kallaspriit/brainbot/README.md

# BrainBot

LLM based self-evolving robot experiment
