kallaspriit/brainbot/solidworks/beam-ball-assembly.SLDASM

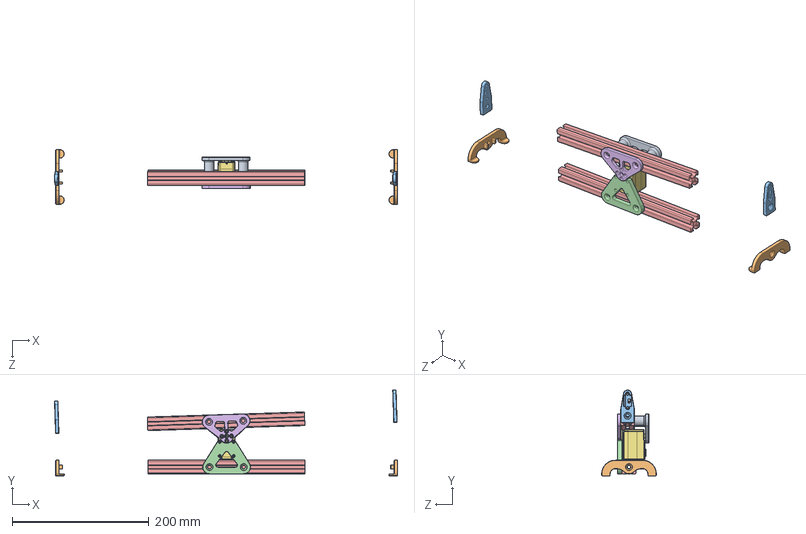
[picture p1: CAD file, 2026-08-09]
solidworks/beam-ball-assembly.SLDASM
501.8 x 125.7 x 80.0 mm
ST3215
servo-pivot
extrusion-20x20 x 2
motor-mount
beam-endstop x 2
rail-foot x 2
pivot-support
