kallaspriit/brainbot/sw/track-support-right.SLDASM

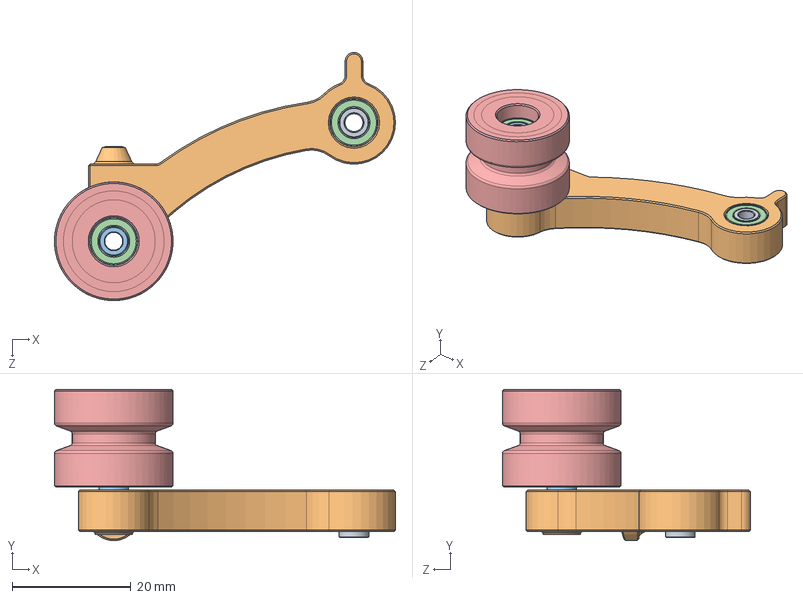
[picture p2: CAD file, 2026-11-13]
sw/track-support-right.SLDASM
57.5 x 25.5 x 41.8 mm
support-wheel
bearing-8x5x2.5 x 4
spacer-5mm-20mm
support-wheel-axle
spacer-5mm-8mm
