kallaspriit/brainbot/sw/idle-wheel-with-bearings.SLDASM

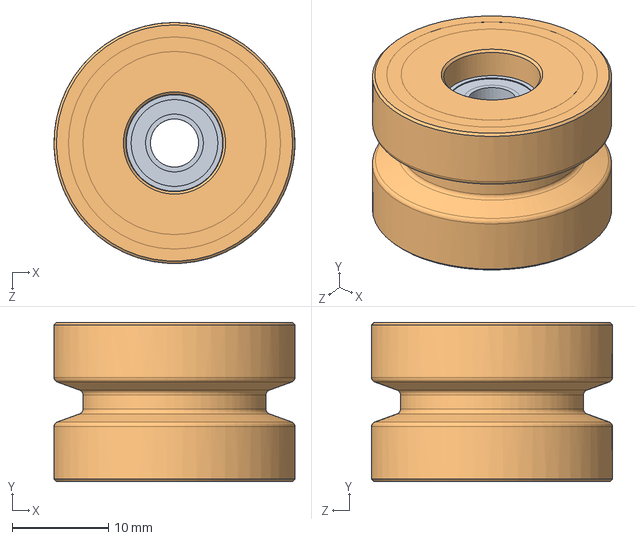
[picture p3: CAD file, 2026-11-11]
sw/idle-wheel-with-bearings.SLDASM
25.0 x 16.5 x 25.0 mm
idle-wheel
bearing-10x5x4 x 2
