kallaspriit/brainbot/solidworks/beam-endstop-sensored-collimator.SLDPRT

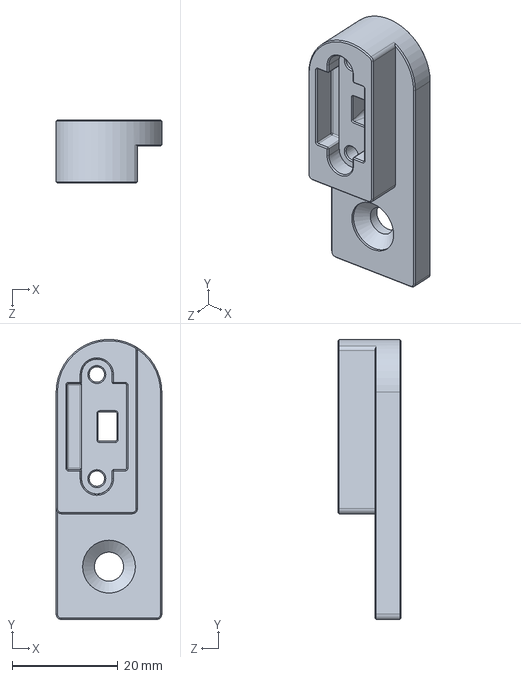
[picture p4: CAD file, 2026-11-05]
solidworks/beam-endstop-sensored-collimator.SLDPRT
20.0 x 53.0 x 12.0 mm
