kallaspriit/brainbot/step/body-side.STEP

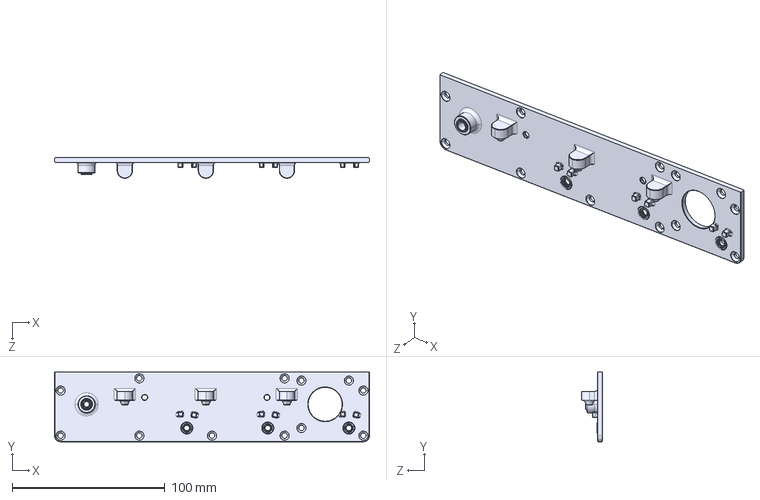
[picture p5: CAD file, 2026-11-14]
step/body-side.STEP
206.0 x 45.5 x 13.5 mm
