kallaspriit/brainbot/stl/damper-mount-fill.STL

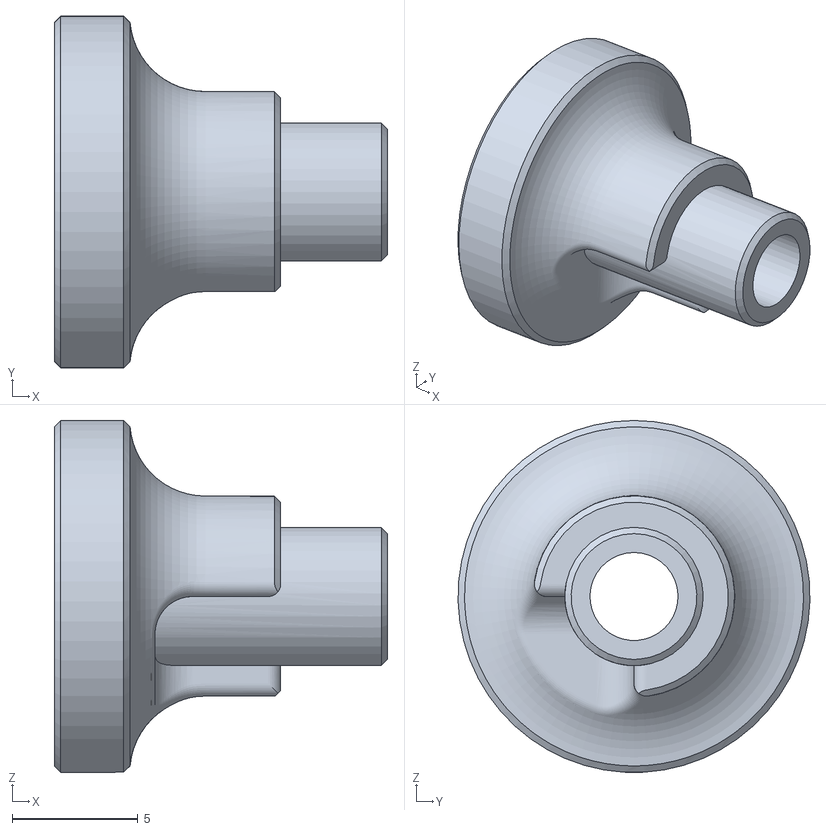
[picture p6: CAD file, 2026-08-09]
stl/damper-mount-fill.STL
13.2 x 14.0 x 14.0
