kallaspriit/brainbot/sw/support-wheel-axle.SLDPRT

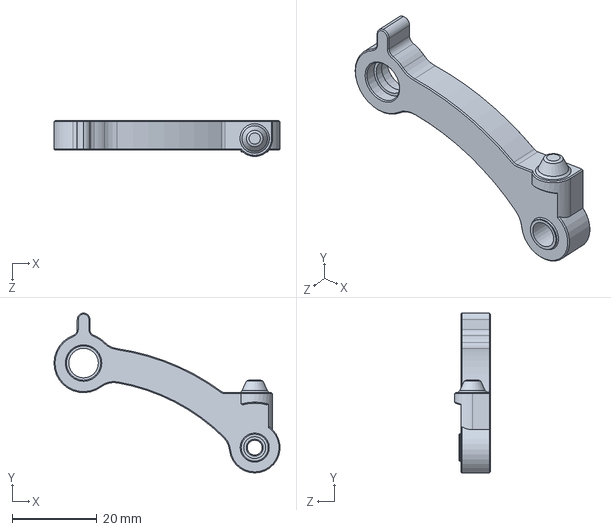
[picture p7: CAD file, 2026-11-14]
sw/support-wheel-axle.SLDPRT
53.5 x 37.8 x 8.50 mm
