kallaspriit/brainbot/step/support-wheel-axle-mirrored.STEP

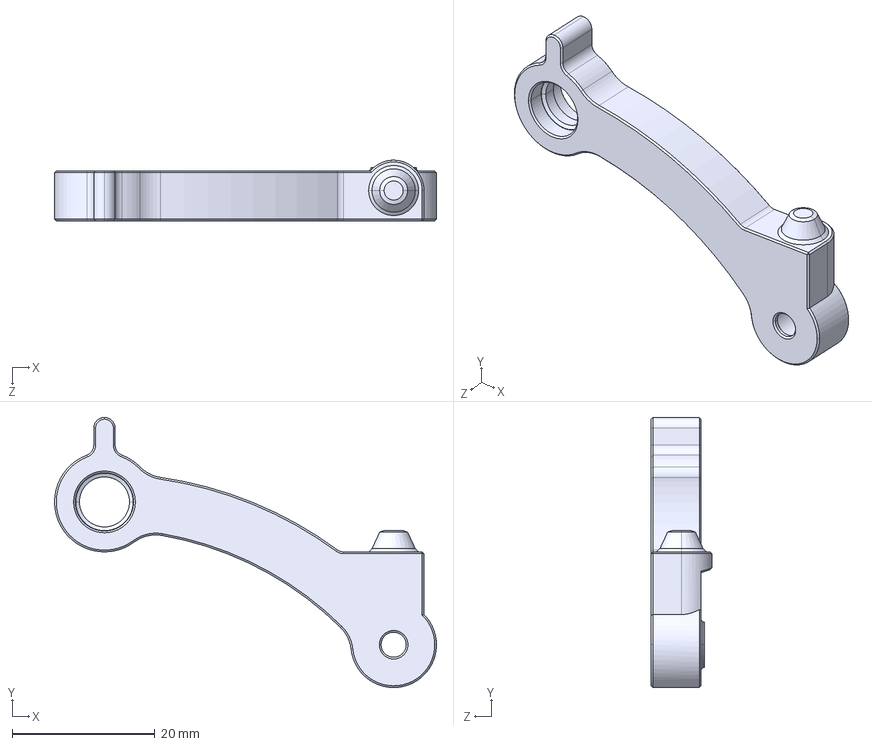
[picture p8: CAD file, 2026-11-14]
step/support-wheel-axle-mirrored.STEP
53.5 x 37.8 x 8.50 mm
