kallaspriit/brainbot/solidworks/beam-endstop.SLDPRT

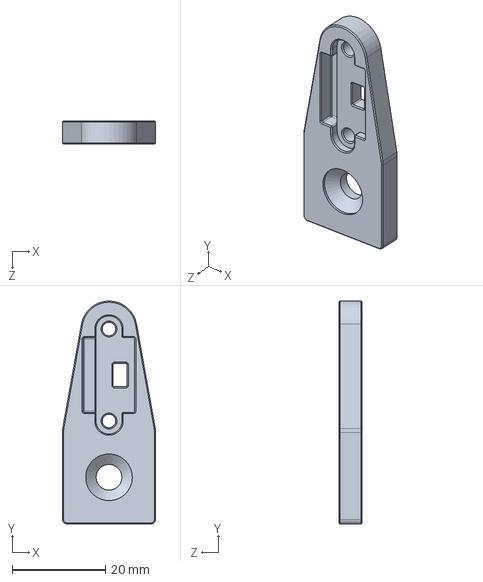
[picture p9: CAD file, 2026-08-09]
solidworks/beam-endstop.SLDPRT
20.0 x 47.7 x 5.00 mm
