kallaspriit/brainbot/step/side-cover-mirrored.STEP

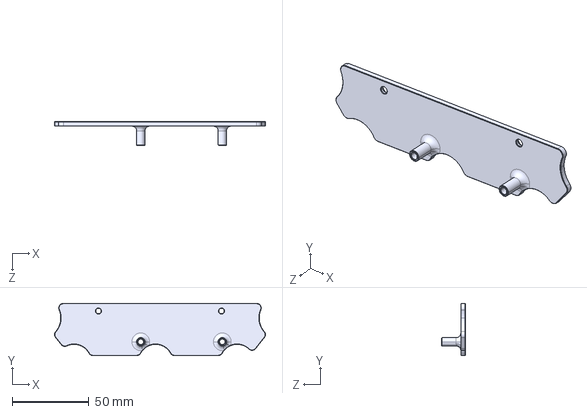
[picture p10: CAD file, 2026-11-14]
step/side-cover-mirrored.STEP
137.1 x 34.0 x 15.5 mm
