kallaspriit/brainbot/solidworks/motor-mount.SLDPRT

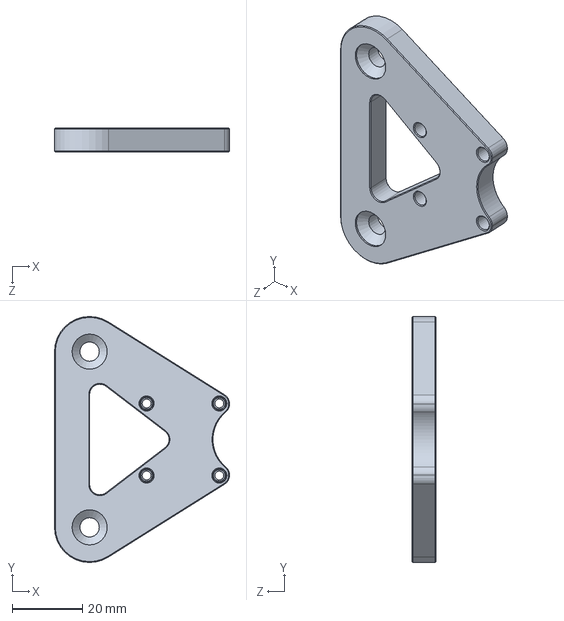
[picture p12: CAD file, 2026-08-09]
solidworks/motor-mount.SLDPRT
49.8 x 70.0 x 6.80 mm
