kallaspriit/brainbot/solidworks/beam-endstop-sensored.SLDPRT

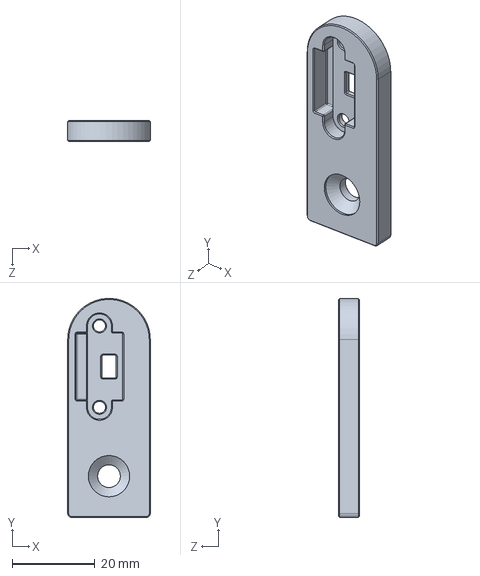
[picture p13: CAD file, 2026-08-09]
solidworks/beam-endstop-sensored.SLDPRT
20.0 x 53.0 x 5.00 mm
