kallaspriit/brainbot/solidworks/pivot-support.SLDPRT

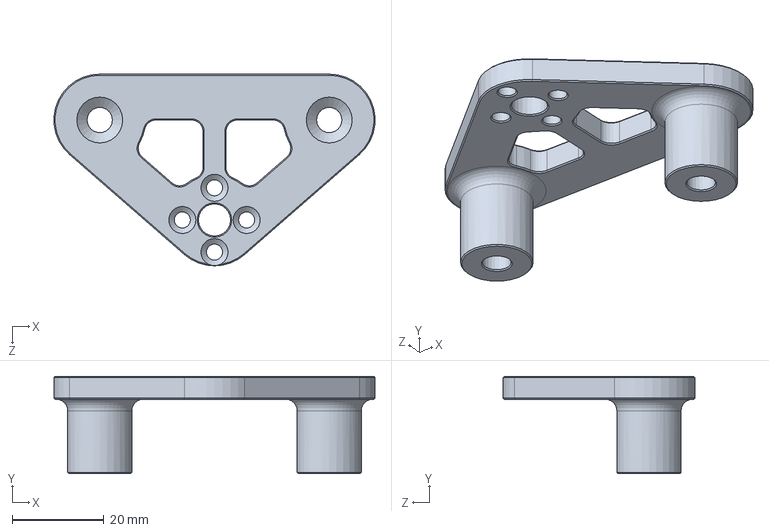
[picture p14: CAD file, 2026-08-09]
solidworks/pivot-support.SLDPRT
69.9 x 21.2 x 41.8 mm
