kallaspriit/brainbot/step/body-tub.STEP

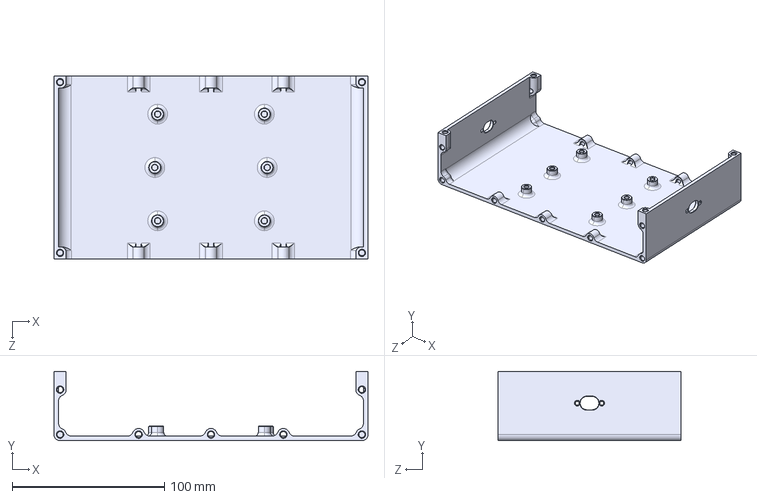
[picture p15: CAD file, 2026-11-14]
step/body-tub.STEP
206.0 x 45.5 x 120.0 mm
