kallaspriit/brainbot/sw/track-generated.SLDPRT

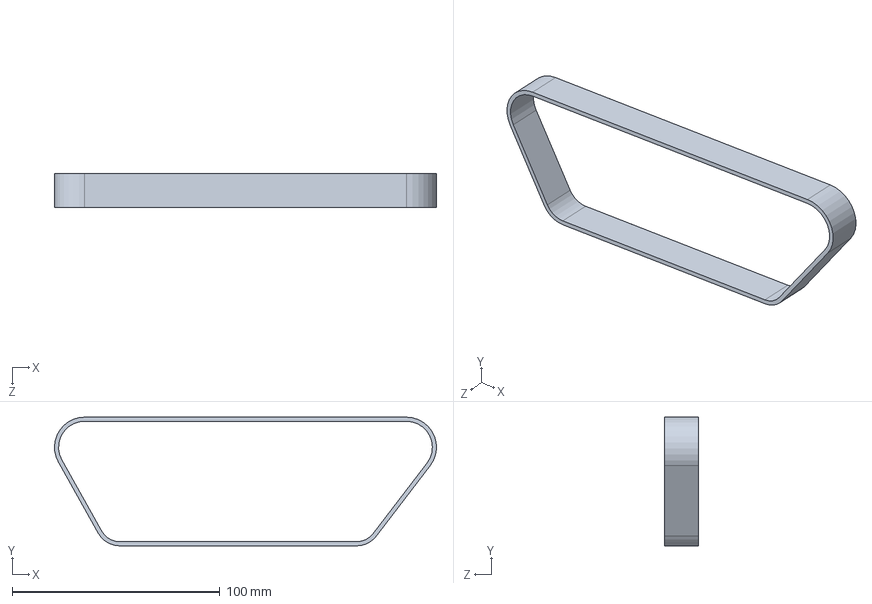
[picture p16: CAD file, 2026-11-13]
sw/track-generated.SLDPRT
184.0 x 62.0 x 16.5 mm
