kallaspriit/brainbot/solidworks/rail-foot.SLDPRT

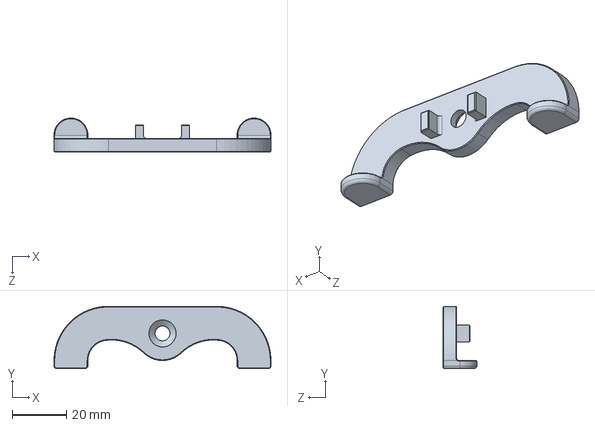
[picture p17: CAD file, 2026-08-06]
solidworks/rail-foot.SLDPRT
80.0 x 23.0 x 12.5 mm
