kallaspriit/brainbot/step/support-wheel.STEP

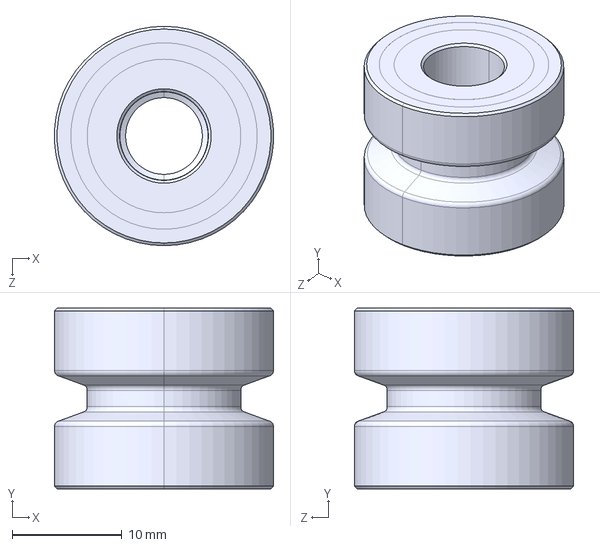
[picture p18: CAD file, 2026-11-11]
step/support-wheel.STEP
20.0 x 16.5 x 20.0 mm
