kallaspriit/brainbot/solidworks/ST3215.SLDPRT

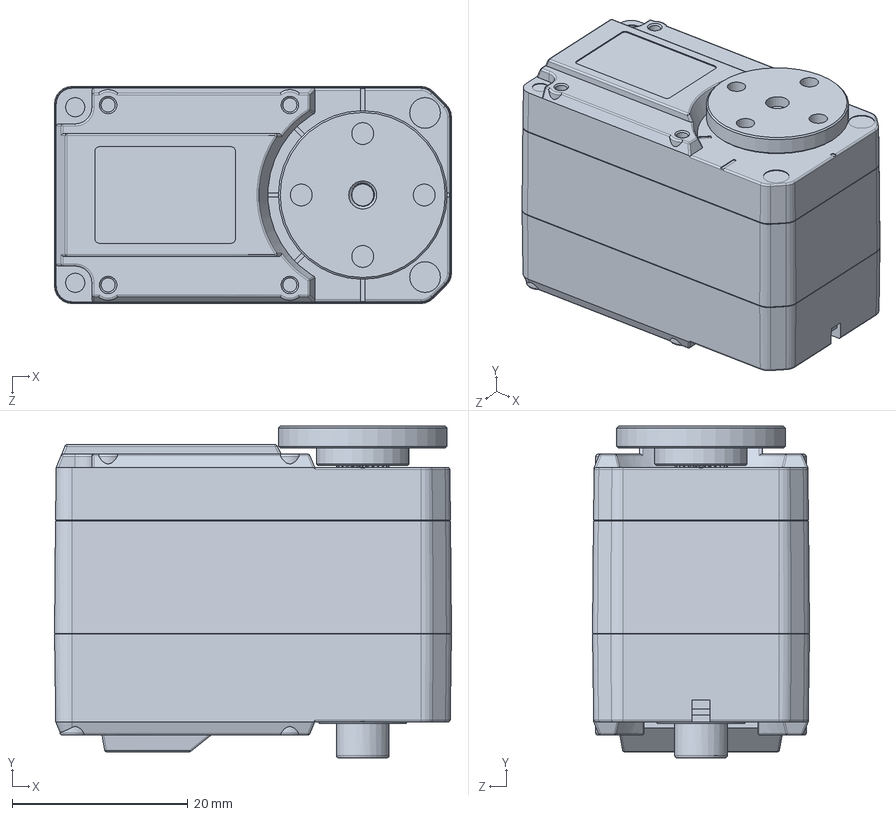
[picture p19: CAD file, 2026-08-06]
solidworks/ST3215.SLDPRT
45.2 x 37.8 x 24.7 mm
