kallaspriit/brainbot/step/idle-wheel.STEP

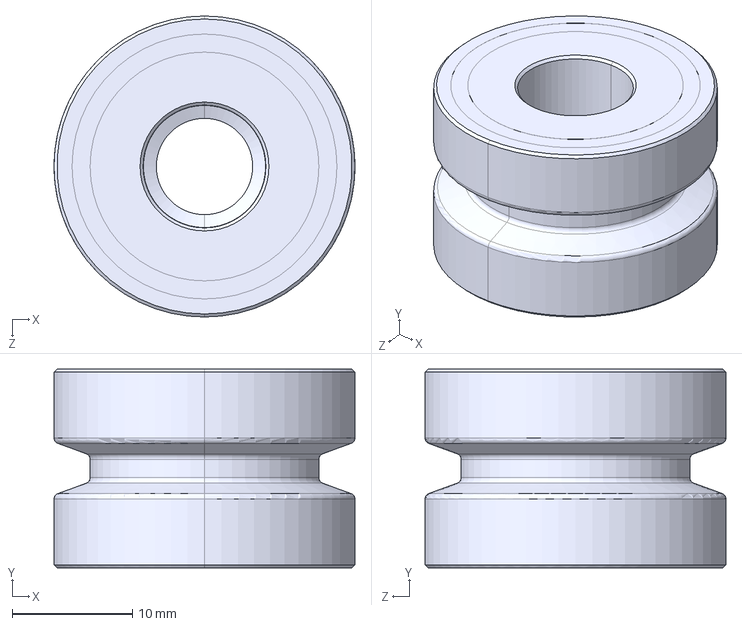
[picture p20: CAD file, 2026-11-11]
step/idle-wheel.STEP
25.0 x 16.5 x 25.0 mm
