kallaspriit/brainbot/solidworks/leg-arm-motor.SLDPRT

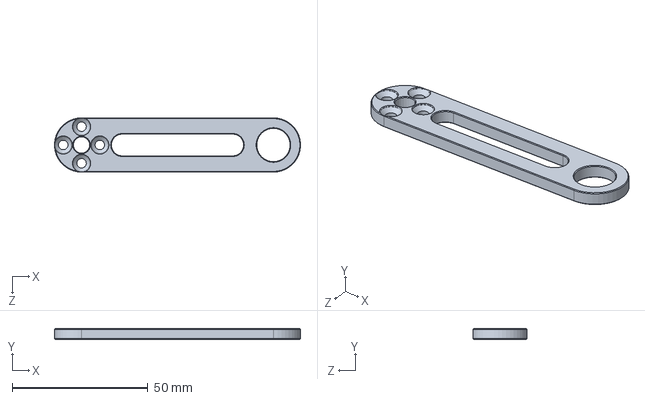
[picture p21: CAD file, 2026-08-06]
solidworks/leg-arm-motor.SLDPRT
90.7 x 4.00 x 20.0 mm
