kallaspriit/brainbot/sw/nimotion-motor.SLDPRT

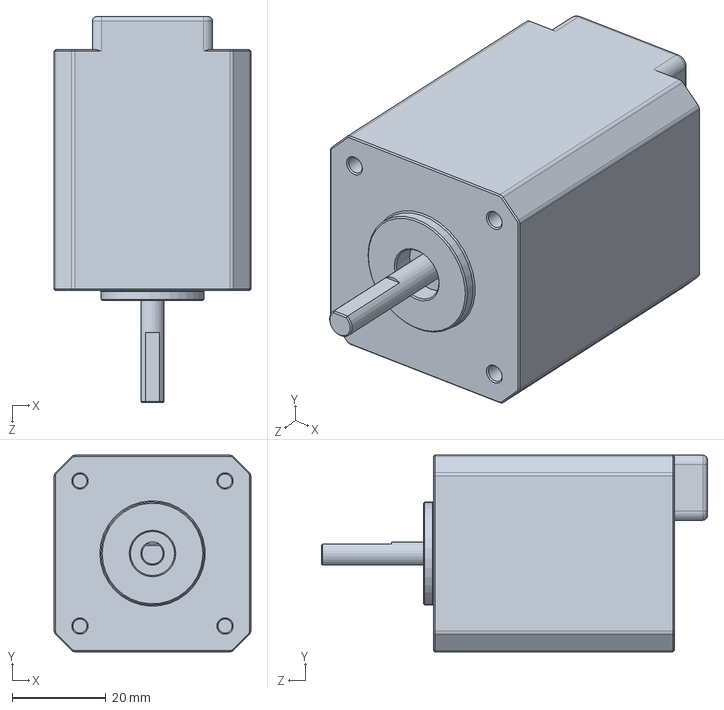
[picture p22: CAD file, 2026-11-13]
sw/nimotion-motor.SLDPRT
42.0 x 42.0 x 82.4 mm
