kallaspriit/brainbot/solidworks/extrusion-20x20.SLDPRT

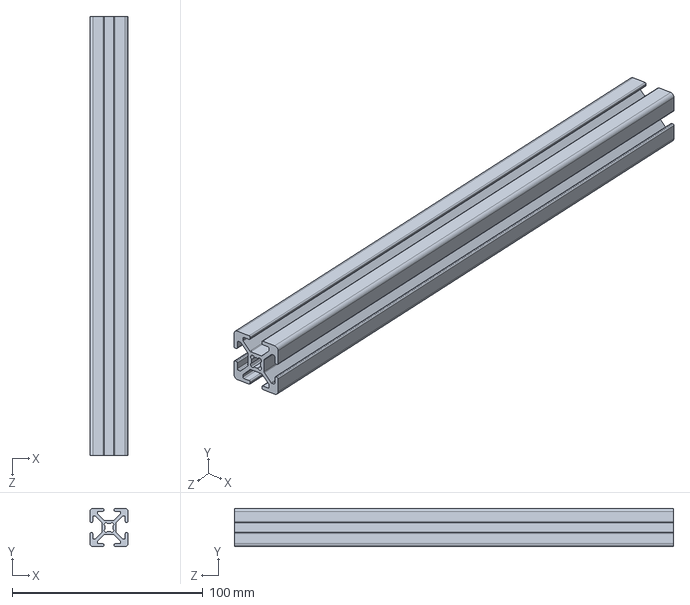
[picture p23: CAD file, 2026-08-06]
solidworks/extrusion-20x20.SLDPRT
20.0 x 20.0 x 230.0 mm
