kallaspriit/brainbot/solidworks/servo-pivot.SLDPRT

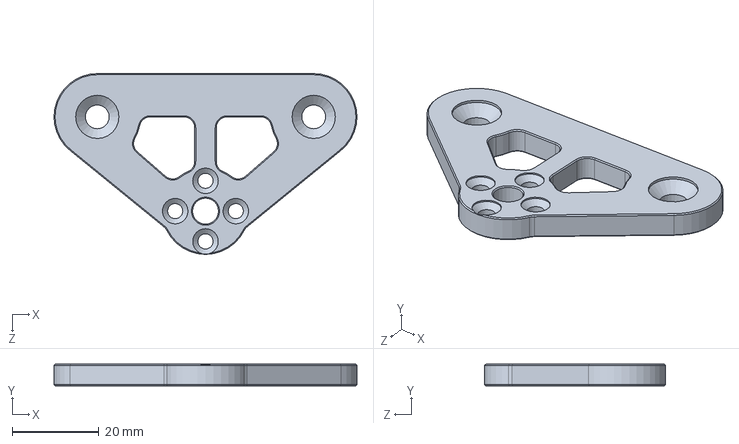
[picture p24: CAD file, 2026-08-06]
solidworks/servo-pivot.SLDPRT
70.0 x 5.00 x 41.8 mm
