kallaspriit/brainbot/sw/bearing-10x5x4.SLDPRT

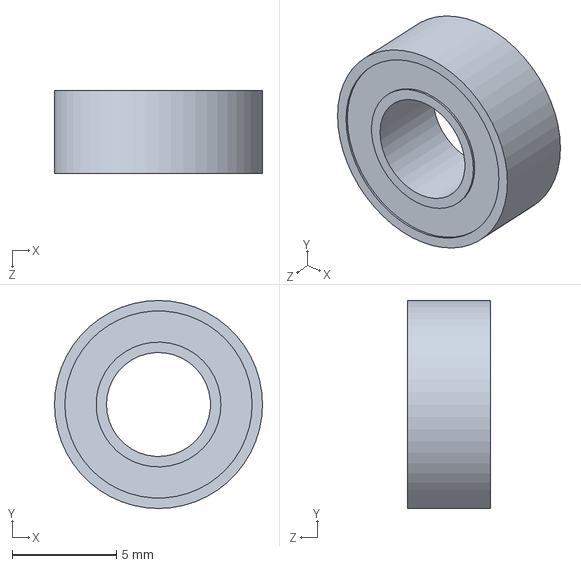
[picture p25: CAD file, 2026-11-10]
sw/bearing-10x5x4.SLDPRT
10.0 x 10.0 x 4.00 mm
