kallaspriit/brainbot/sw/bearing-12x6x4.SLDPRT

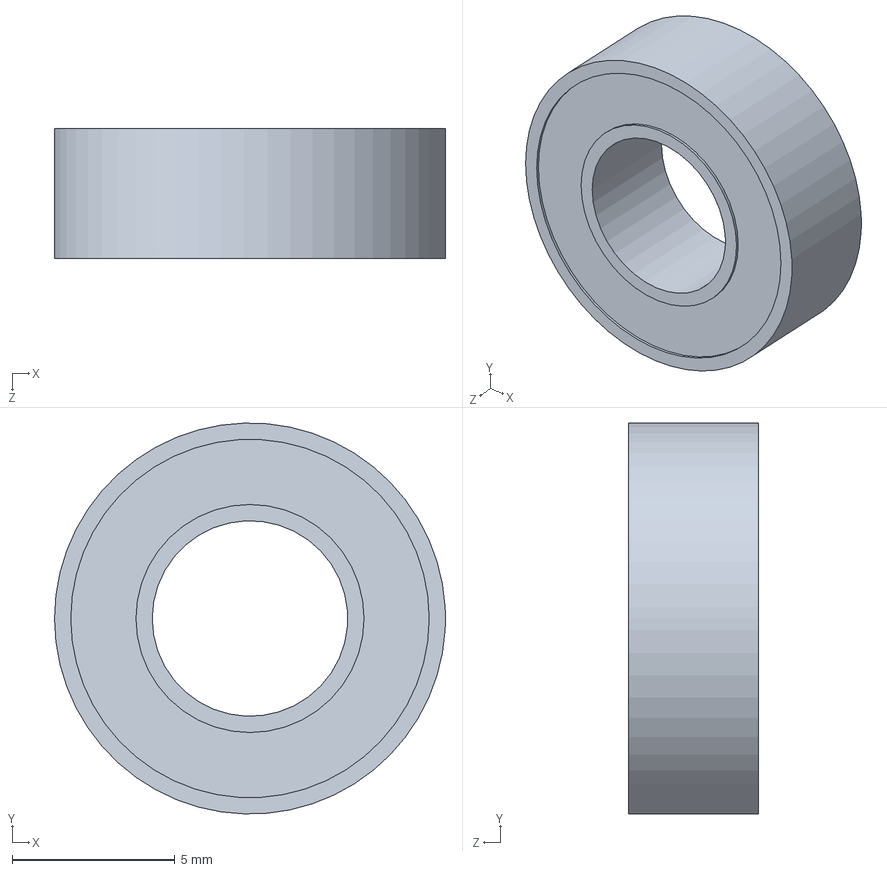
[picture p26: CAD file, 2026-11-10]
sw/bearing-12x6x4.SLDPRT
12.0 x 12.0 x 4.00 mm
