kallaspriit/brainbot/sw/idle-axis.SLDPRT

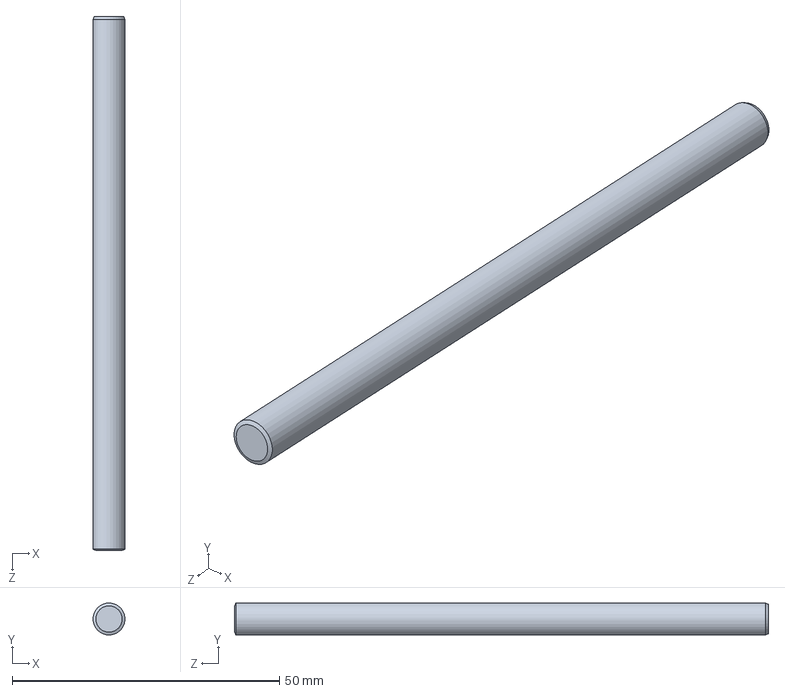
[picture p27: CAD file, 2026-11-10]
sw/idle-axis.SLDPRT
6.00 x 5.99 x 100.0 mm
