kallaspriit/brainbot/sw/bearing-8x5x2.5.SLDPRT

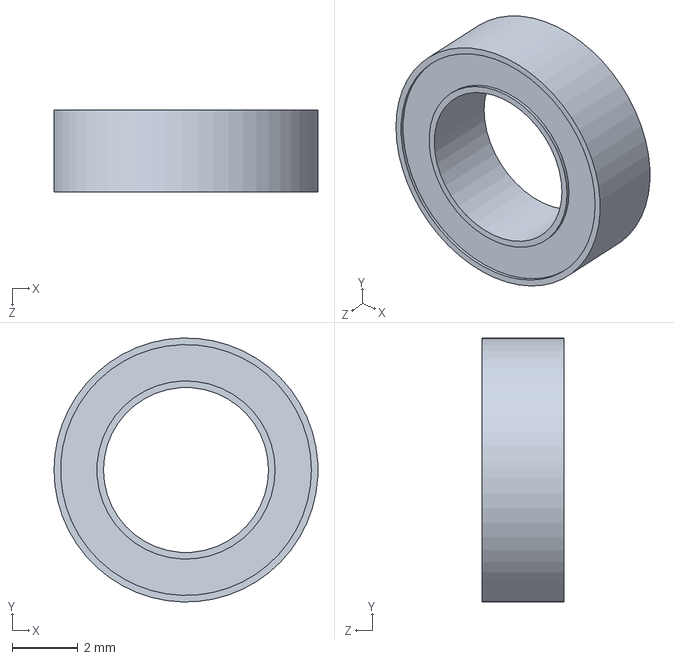
[picture p28: CAD file, 2026-11-10]
sw/bearing-8x5x2.5.SLDPRT
8.00 x 8.00 x 2.50 mm
