kallaspriit/brainbot/sw/spacer-5mm-20mm.SLDPRT

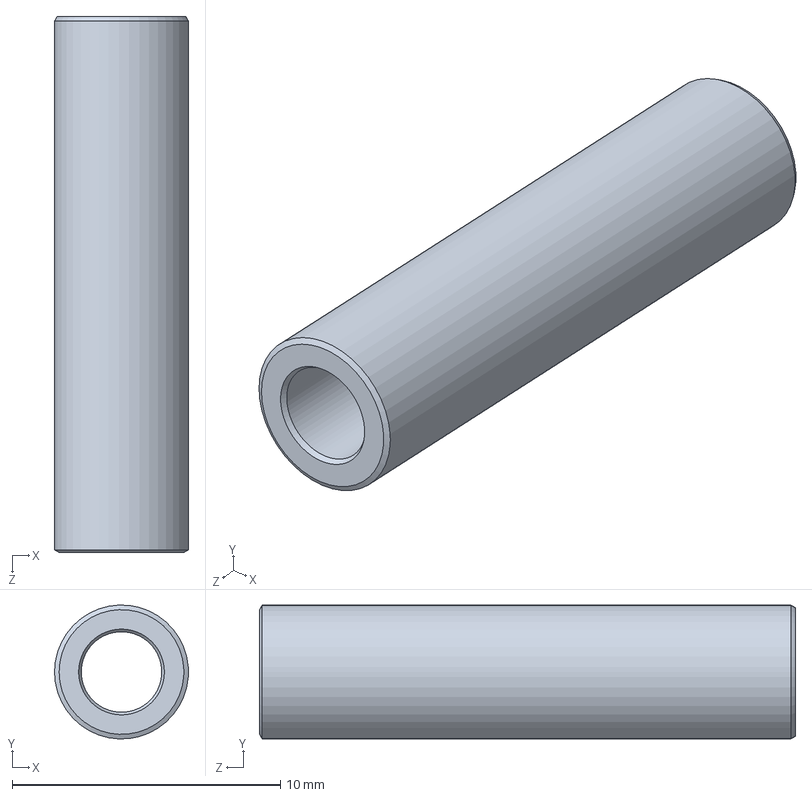
[picture p29: CAD file, 2026-11-10]
sw/spacer-5mm-20mm.SLDPRT
5.00 x 5.00 x 20.0 mm
