kallaspriit/brainbot/sw/spacer-5mm-8mm.SLDPRT

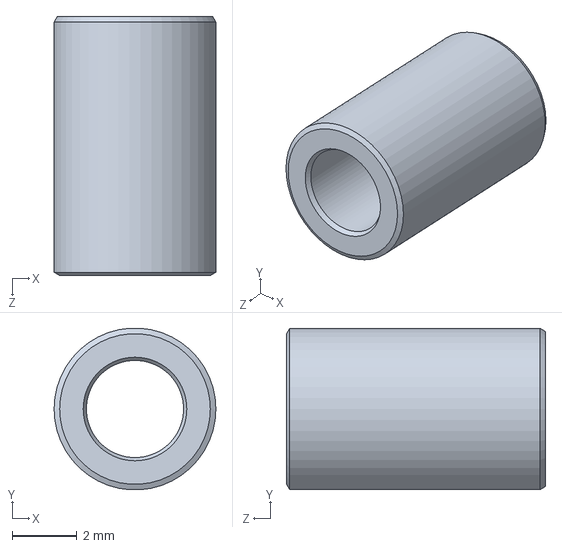
[picture p30: CAD file, 2026-11-10]
sw/spacer-5mm-8mm.SLDPRT
5.00 x 4.99 x 8.00 mm
