kallaspriit/brainbot/sw/track.SLDPRT

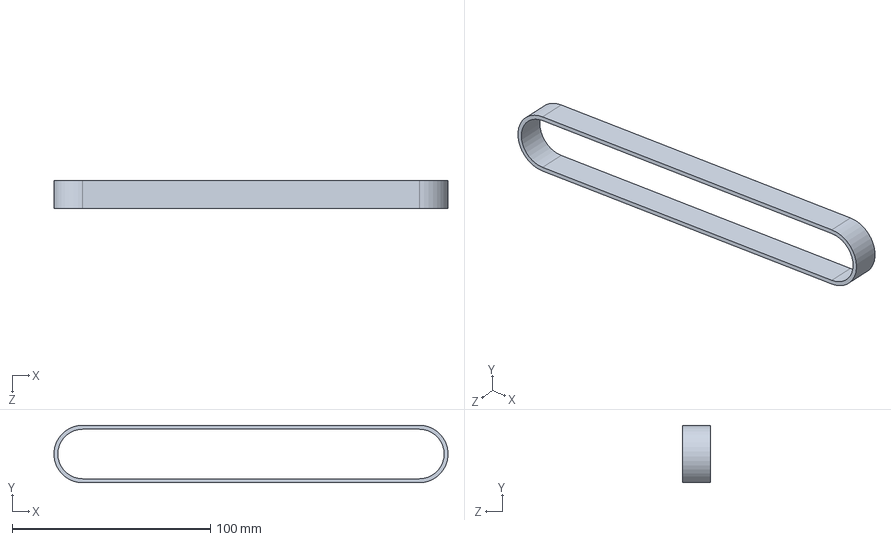
[picture p31: CAD file, 2026-11-05]
sw/track.SLDPRT
198.9 x 29.0 x 14.0 mm
