kallaspriit/brainbot/sw/robot-side.SLDASM

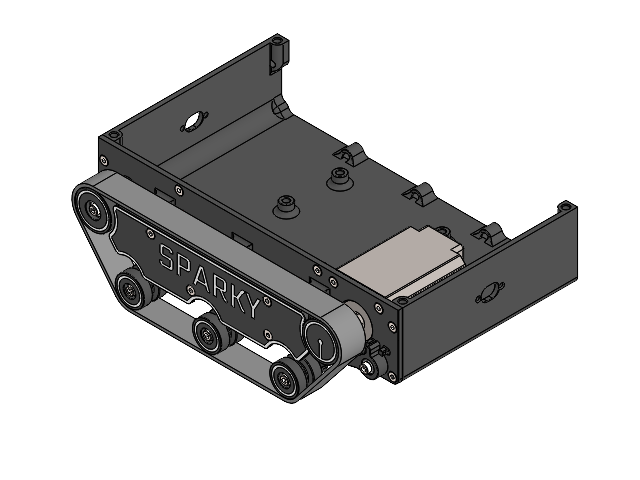
[picture p32: CAD file, 2026-11-14]
sw/robot-side.SLDASM
nimotion-motor
drive-wheel
body-side
idle-wheel
bearing-10x5x4 x 2
track-generated
spacer-5mm-20mm x 6
side-cover
body-tub
support-wheel x 3
bearing-8x5x2.5 x 12
B18.3.1M - 3 x 0.5 x 8 Hex SHCS -- 8NHX x 4
support-wheel-axle x 3
spacer-5mm-8mm x 3
B18.3.1M - 2.5 x 0.45 x 4 Hex SHCS -- 4NHX x 3
B18.3.5M - 3 x 0.5 x 6 Socket FCHS -- 6N x 13
B18.3.5M - 3 x 0.5 x 8 Socket FCHS -- 8N x 6
B18.3.5M - 3 x 0.5 x 20 Socket FCHS -- 20N x 2
B18.3.1M - 3 x 0.5 x 12 Hex SHCS -- 12NHX
