kallaspriit/brainbot/sw/robot.SLDASM

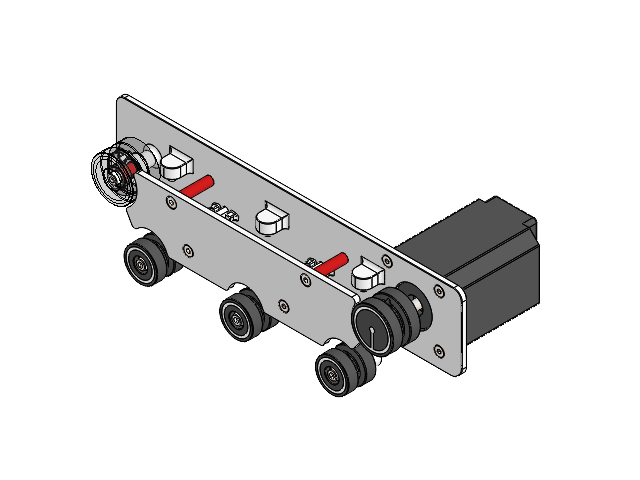
[picture p33: CAD file, 2026-11-11]
sw/robot.SLDASM
nimotion-motor
drive-wheel
support-wheel x 3
bearing-8x5x2.5 x 12
spacer-5mm-20mm x 6
B18.3.1M - 3 x 0.5 x 8 Hex SHCS -- 8NHX x 4
support-wheel-axle x 3
spacer-5mm-8mm x 3
B18.3.1M - 2.5 x 0.45 x 4 Hex SHCS -- 4NHX x 3
body-side
idle-wheel
bearing-10x5x4 x 2
Part10^robot
B18.3.5M - 3 x 0.5 x 6 Socket FCHS -- 6N x 7
side-cover
B18.3.1M - 3 x 0.5 x 5 Hex SHCS -- 5NHX
B18.3.5M - 3 x 0.5 x 8 Socket FCHS -- 8N x 5
B18.3.5M - 3 x 0.5 x 20 Socket FCHS -- 20N x 2
