kallaspriit/brainbot/(list of files, cad)

Other CAD files:
sw/track-support-left.SLDASM
sw/track-support.SLDASM
solidworks/damper-mount.SLDPRT
sw/body-side.SLDPRT
step/body-side-mirrored.STEP
step/support-wheel-axle.STEP
sw/side-cover.SLDPRT
sw/body-tub.SLDPRT
step/drive-wheel.STEP
sw/drive-wheel.SLDPRT
sw/idle-wheel.SLDPRT
sw/support-wheel.SLDPRT
stl/beam-endstop-sensored-collimator.STL
stl/beam-endstop-sensored.STL
stl/beam-endstop.STL
stl/damper-mount.STL
stl/motor-mount.STL
stl/pivot-support.STL
stl/rail-foot.STL
stl/servo-pivot.STL
