kallaspriit/brainbot/firmware/src/Config.hpp

#pragma once

#include <stddef.h>
#include <stdint.h>

/**
 * Wiring and tuning constants for the ball & beam rig.
 *
 * Anything that describes the physical machine lives here, so a change of pin,
 * servo, or beam length is a one-line edit rather than a hunt through the
 * modules that use it.
 */
namespace Config {

// --- Servo bus ---

// Single GPIO shared with the servo bus, through a ~1k series resistor.
constexpr unsigned int kServoPin = 23;

// STS3215 servos ship at 1 Mbps.
constexpr unsigned int kServoBaud = 1000000;

// Servo driving the beam, coupled directly to the pivot at the beam's centre.
constexpr uint8_t kBeamServoId = 3;

// Highest ID probed by the "scan" command.
constexpr uint8_t kMaxScanId = 20;

// Most servos a single "sync"/"syncread" command can address.
constexpr size_t kMaxSyncServos = 8;

// --- Beam servo tuning ---

// Applied at boot so the rig behaves identically after a servo swap or an
// EEPROM reset, rather than depending on gains someone typed in once.
//
// The factory default (Kp 10) is far too soft for the beam's inertia: a 4 deg
// step slews at ~19 deg/s and then creeps onto target for several seconds.
// Kp 120 / Kd 120 slews at ~40 deg/s and settles a 0.5 deg step within a sample
// or two with no measurable overshoot.
//
// Ki is deliberately zero. The servo's deadband hides the final encoder count
// from its own integrator, so integral action buys nothing at rest and only
// winds up during the saturated part of a transient. Integral action belongs in
// the outer ball loop, where it can actually see the error it is correcting.
constexpr uint8_t kBeamServoKp = 120;
constexpr uint8_t kBeamServoKd = 120;
constexpr uint8_t kBeamServoKi = 0;

// Position error the servo treats as "arrived", in encoder steps.
//
// Zero, and it matters far more than it looks. The factory default of 1 step
// creates a dead zone the beam cannot resolve inside, which is invisible on a
// 4 deg swing and crippling on a small one: measured small-signal gain at
// +-0.5 deg was 0.66 with a deadband of 1, and 0.94 with it at 0. A regulator
// spends all its time in exactly that small-signal regime, so the difference is
// a third of the loop gain right at the operating point.
constexpr uint8_t kBeamServoDeadband = 0;

// Real beam degrees per nominal degree of servo travel, where nominal assumes
// the encoder's 4096 counts span a full revolution.
//
// Measured with a digital inclinometer: commanding 4 deg gives 3.65, and -4 gives
// -3.75. Symmetric about zero, so this is a scale error and not a zero offset —
// 0.925 * 360 = 333 deg, which suggests the counts do not span a revolution the
// way the datasheet implies. Worth re-checking at +-10 deg, where the meter's own
// absolute error matters proportionally less.
constexpr float kBeamAngleScale = 0.925f;

// Servo angle at which the beam is actually level, in real degrees.
//
// Measured with a digital inclinometer across nine commanded angles from -4 to
// +4: actual = 1.017 * commanded - 0.206. The slope is within measurement error
// of 1.0, so the scale above is right, but the offset is consistent and real.
constexpr float kBeamTrimDegrees = 0.2f;

// Beam angles beyond this are clamped. The controller never needs more than a
// few degrees, so this is a backstop against a runaway command dumping the ball
// off the end or driving the beam into the bench.
constexpr float kMaxBeamAngleDegrees = 12.0f;

// --- Distance sensor ---

// VL53L0X sits on Wire1 at the left endstop, looking down the beam.
constexpr unsigned int kDistanceSensorSdaPin = 14;
constexpr unsigned int kDistanceSensorSclPin = 15;

// Continuous ranging period; the sensor produces a new reading at roughly this
// rate and the control tick consumes them as they land.
constexpr uint32_t kRangingPeriodMs = 30;

// Readings outside this window are not measurements. The VL53L0X reports failed
// ranging as a large value (8190 out of range, 65535 on error) rather than as an
// error, and cannot resolve closer than ~30 mm.
constexpr uint16_t kMinDistanceMm = 30;
constexpr uint16_t kMaxDistanceMm = 600;

// --- Startup behaviour ---

// Whether to pause at boot for a serial monitor to attach. Off, so the rig
// starts balancing on power alone rather than sitting idle for eight seconds
// waiting for a host that may never connect.
constexpr bool kWaitForSerialOnBoot = false;

// Whether to install a controller at boot and start balancing immediately.
//
// Note this means the beam takes torque at power-up rather than waiting to be
// asked, which is the whole point when the rig is plugged in to demonstrate
// itself, but is worth knowing before reaching across it. "ctrl off" stops it.
constexpr bool kAutoStartController = true;

// --- Loop rates ---

// Control tick on core 1. Faster than the sensor on purpose: the estimator
// predicts between measurements, so the actuator is driven smoothly rather than
// in 30 ms staircases.
constexpr unsigned long kControlIntervalMs = 10;

// Telemetry frame period on core 0. ~33 Hz by default, which is enough for
// watching the ball but aliases the servo's step response; "debugrate" raises it
// for characterization runs.
constexpr unsigned long kDefaultDebugIntervalMs = 30;
constexpr unsigned long kMinDebugIntervalMs = 2;
constexpr unsigned long kMaxDebugIntervalMs = 1000;

// --- Ball position estimate ---

// Measurement noise grows with distance, because a time-of-flight sensor's
// return signal falls as 1/d^2 and its noise with the square root of that. Fitted
// to two measured points: sigma 13.5 mm at 292 mm, 31.9 mm at 546 mm.
//
//   sigma(d) = kSensorNoiseBaseMm + kSensorNoiseQuadratic * d^2
//
// Feeding the filter one fixed noise figure would make it trust the far end of
// the beam six times more than it deserves, which is where it can least afford
// to be wrong.
constexpr float kSensorNoiseBaseMm = 6.2f;
constexpr float kSensorNoiseQuadratic = 8.6e-5f;

// Ball acceleration per degree of beam tilt, mm/s^2 per degree, signed so that
// positive means the ball accelerates towards larger distance readings.
//
// Zero, which disables the tilt model and leaves a plain constant-velocity
// filter — the standard, well-behaved baseline.
//
// The open-loop roll tests said 205-228, with residuals matching sensor noise, so
// the fit itself was sound. But that exceeds 171, the acceleration of a
// frictionless block on the same incline, which nothing rolling can beat; and in
// closed loop the ball plainly accelerates far more slowly than 215 predicts. A
// model that confident and that wrong is worse than no model: the filter cannot
// reject it, so it carries a fictitious velocity instead, which a velocity-based
// controller then faithfully regulates into a standing position error.
//
// Closed-loop testing settled it: at a commanded and delivered -1.0 deg the ball
// does not move at all. Static friction dominates below roughly a degree, so the
// small-signal plant gain a regulator actually sees is near zero, and the roll
// tests were measuring kinetic behaviour at 4 deg that says nothing about it.
//
// With the model at 100, the velocity loop reaches equilibrium where the filter's
// phantom velocity equals the demanded velocity — the integral stops winding and
// the ball parks short of target. Zero is not a workaround here, it is the
// honest model for the regime this controller lives in.
constexpr float kAccelPerDegree = 50.0f;

// Acceleration the model does not account for: rolling friction, the ball
// slipping rather than rolling, the beam flexing. Sets how quickly the filter is
// willing to abandon its prediction in favour of the measurements.
constexpr float kProcessNoiseMmPerS2 = 400.0f;

// A measurement further than this many standard deviations from the prediction
// is treated as an outlier rather than as news. Generous, because the cost of
// rejecting a real measurement is worse than the cost of accepting a bad one.
constexpr float kInnovationGateSigma = 4.0f;

// Consecutive rejections before the filter concludes its state is wrong rather
// than the measurements, and reinitializes. This is what happens when the ball
// is picked up and put down somewhere else.
constexpr uint8_t kMaxConsecutiveRejects = 6;

// Initial velocity uncertainty when the filter starts or restarts.
constexpr float kInitialVelocitySigmaMmPerS = 300.0f;

// How far the ball must move from where it started before "rolltest" begins
// fitting. A timed settle window cannot do this job: it skips stiction but not
// the sensor's near-range floor, where readings stay pinned at ~35 mm while the
// ball is already moving. Fitting that flat stretch trades the acceleration away
// against a fictitious initial velocity.
constexpr float kRollTriggerMm = 25.0f;

// Give up if the ball has not moved within this long — the beam may be level, or
// the ball may not be on it.
constexpr unsigned long kRollTriggerWaitMs = 3000;

// The roll fit stops here rather than following the ball to the endstop.
//
// Past roughly this distance the sensor stops measuring the ball. Its return
// falls off as 1/d^2 and the 25 degree cone also contains the rails and the far
// endstop, whose returns sit near 600 mm — so the readings run ahead of the ball
// and the apparent acceleration climbs with distance, which a constant tilt
// cannot produce. Fitting that region inflated the constant past the acceleration
// of a frictionless block on the same incline.
constexpr float kRollMaxFitMm = 350.0f;

// --- PID controller ---

// Sized from the measured plant rather than guessed: with ball acceleration
// a = k * angle, a second-order closed loop of natural frequency w and damping
// ratio z needs kp = w^2 / k and kd = 2*z*w / k.
//
// w = 2 rad/s and z = 0.8 give a settle of a couple of seconds without overshoot,
// which is about as fast as this rig's ~20 degrees of backlash phase allows.
constexpr float kPidKp = 0.019f; // degrees per mm of error
constexpr float kPidKd = 0.015f; // degrees per mm/s of ball velocity

// Integral action starts off. The beam's mechanical zero is already trimmed, so
// there is no standing error for it to remove, and integral action on a double
// integrator costs phase margin exactly where this plant has least to spare.
constexpr float kPidKi = 0.0f; // degrees per mm-second

// Hard limit on the integral term's contribution, in degrees. Anti-windup: a
// ball held against an endstop would otherwise wind this up without limit and
// then take just as long to unwind once it came free.
constexpr float kPidMaxIntegralDegrees = 2.0f;

// --- Cascade controller ---

// Outer loop: position error to a desired ball velocity, in 1/s. The ball then
// approaches with a first-order time constant of 1/gain, so 0.7 settles in about
// one and a half seconds.
constexpr float kCascadePositionGain = 0.7f;

// The point of the whole structure. A single PID answers a large setpoint change
// with a large angle and the ball arrives carrying all the speed that built up on
// the way; here the approach speed is simply capped, so it arrives at a rate the
// inner loop can still stop.
constexpr float kCascadeMaxVelocityMmPerSecond = 150.0f;

// Inner loop: velocity error to beam angle, in degrees per mm/s. With ball
// acceleration a = k * angle, a gain of g gives the velocity loop a time constant
// of 1/(k*g) — about 0.3 s here, comfortably inside the outer loop's 1.4 s.
constexpr float kCascadeVelocityGain = 0.015f;

// Integral on the position loop, in 1/s^2. This is the one that matters: it
// integrates the error we actually care about, so the ball has to arrive at the
// target rather than merely stop moving.
//
// It also survives a biased velocity estimate. The velocity integral below
// cannot: with the tilt model on, the ball sitting still and the filter reporting
// a phantom velocity, the velocity error can be driven to zero at any position,
// so the loop parks wherever it happens to be. Position error has no such null.
constexpr float kCascadePositionIntegral = 0.1f;

// Ceiling on the position integral's contribution, in mm/s.
constexpr float kCascadeMaxIntegralVelocity = 50.0f;

// Integral on the velocity loop, degrees per mm. Zero: integral action belongs in
// one loop or the other, and two integrators in series contribute 180 degrees of
// lag between them before the plant's own double integration is counted.
constexpr float kCascadeVelocityIntegral = 0.0f;

// --- Beam geometry ---

// Distance reading with the ball at the centre of travel, used as the default
// setpoint. Measured, not derived: the sensor sits behind the endstop face.
constexpr float kBeamCentreMm = 300.0f;

} // namespace Config
