kallaspriit/brainbot/(commit log)

2026-08-06 Started modelling beam ball balancer, added simple testing firmware
    [ST3215.SLDPRT, beam-ball-assembly.SLDASM, beam-endstop.SLDPRT, beam-endstop.STL, extrusion-20x20.SLDPRT, leg-arm-motor.SLDPRT, motor-mount.SLDPRT, motor-mount.STL]
2026-08-09 Added damper mounts, improved firmware with debug/tilt on/off
    [beam-ball-assembly.SLDASM, beam-endstop-sensored.SLDPRT, beam-endstop-sensored.STL, beam-endstop.SLDPRT, beam-endstop.STL, damper-mount-fill.STL, damper-mount.SLDPRT, damper-mount.STL]
2026-08-11 Working on ball estimator and noise test, roll test
    [BallBeamSystem.cpp, BallBeamSystem.hpp, BallEstimator.cpp, BallEstimator.hpp, BallRollTest.cpp, BallRollTest.hpp, BallSensor.hpp, Config.hpp]
2026-08-12 Implemented pid beam controller, somewhat works
2026-11-05 Modelled drive wheel, nimotion motor, track size
2026-11-10 Working on track support, support wheel
2026-11-10 Added idle wheel, improved body and track support
2026-11-10 Working on track supports layout
2026-11-10 Added generated track
2026-11-10 Refactored idle wheel
2026-11-11 Added support axles limits, various improvements
2026-11-12 Started on body side tub holes
2026-11-13 Added mirrored support wheel axle and side cover
2026-11-13 Improved tub mounts
2026-11-13 Widened tub for side-by-side motors
2026-11-13 Changed motor drive side
